Cocotrilito/watchywatch/bom.csv

Item | Qty | Purpose | Funding | UnitPriceUSD | TotalUSD | Supplier | Notes
HALO-0 RP2040 Board | 1 | Main controller | No | 0 | 0 | https://github.com/Cocotrilito/HALO-0 | Previously designed by me and reused as the main controller
4-Digit 7-Segment Display | 1 | Main time display | Yes | 1.39 | 1.39 | https://megatronica.cc/producto/display-multiplexado-4-digitos/ | 0.56 inch common-anode red display
74HC595 DIP-16 | 2 | Reduce GPIO usage and drive display segments/digit selection | Yes | 0.95 | 1.90 | https://www.electronicajnc.com/web/producto/shift-register-74hc595/ | DIP-16 shift register; card payment still needs confirmation with supplier
2N3906 PNP Transistor | 4 | High-side switching for the four common-anode digits | Yes | 0.25 | 1.00 | https://novatronicec.com/index.php/product/transistor-2n3906-pnp/ | TO-92 package
DS1302 RTC Module | 1 | Keep time while the main system is powered off | Yes | 3.60 | 3.60 | https://novatronicec.com/ | 3-wire RTC module
LiPo Battery 401030 | 1 | Main rechargeable power source | Yes | 2.50 | 2.50 | https://www.cineto.net/producto/bateria-lipo-90mah-3-7v-401030/ | 3.7V 90mAh, 30x10x4 mm; payment method should be confirmed
134N3P / TP5400 Power Module | 1 | Charge the LiPo and boost battery voltage to 5V | Yes | 2.55 | 2.55 | https://novatronicec.com/index.php/product-category/fuentes-y-adaptadores-de-voltaje/ | 20x18.2x10.5 mm
Push Button 6x6x5mm | 2 | MODE and SET user inputs | Yes | 0.25 | 0.50 | https://novatronicec.com/ | Momentary tactile switches
Mini Power Switch | 1 | Main ON/OFF control | Yes | 0.60 | 0.60 | https://megatronica.cc/ | Small manual power switch
Blue LED 5mm | 1 | Status indicator | Yes | 0.10 | 0.10 | https://megatronica.cc/ | Blue indicator LED
LDR 5528 | 1 | Ambient light sensing for automatic display brightness | Yes | 0.40 | 0.40 | https://novatronicec.com/ | 5mm photoresistor
330 Ohm Resistor | 9 | Limit current for display segments and blue LED | Yes | 0.05 | 0.45 | https://tecmikro.com/resistencias-electricas-potenciometros/184-resistencias-de-14w.html | 1/4W
2.2k Ohm Resistor | 4 | Limit PNP base current | Yes | 0.05 | 0.20 | https://tecmikro.com/resistencias-electricas-potenciometros/184-resistencias-de-14w.html | 1/4W
10k Ohm Resistor | 5 | PNP pull-ups and LDR voltage divider | Yes | 0.05 | 0.25 | https://tecmikro.com/resistencias-electricas-potenciometros/184-resistencias-de-14w.html | 1/4W
100k Ohm Resistor | 2 | Battery voltage sensing divider | Yes | 0.05 | 0.10 | https://tecmikro.com/resistencias-electricas-potenciometros/184-resistencias-de-14w.html | 1/4W
100nF Ceramic Capacitor | 2 | Decouple the two 74HC595 ICs | Yes | 0.25 | 0.50 | https://megatronica.cc/producto/capacitor-ceramico-01-uf-100nf-104-250v-2/ | 0.1uF ceramic through-hole capacitor
Perfboard 5x7cm | 1 | Hand-soldered point-to-point electronics assembly | Yes | 0.95 | 0.95 | https://megatronica.cc/store/page/32/ | Will be cut down to the size required by the enclosure
Hookup Wire | 1 | Internal point-to-point wiring | Yes | 3.99 | 3.99 | https://megatronica.cc/store/page/32/ | 1 meter 40-wire Dupont ribbon can be separated into individual wires
3D Printed Enclosure | 1 | Custom wearable enclosure | No | 0 | 0 | TBD | Designed in Fusion 360 and printed using my own 3D printer
Watch Strap | 1 | Attach the device to the wrist | Yes | TBD | TBD | TBD | Must fit the strap slots modeled into the enclosure
