Cocotrilito/watchywatch/ArtyomWatchv1.kicad_sch

## KiCad design ArtyomWatchv1.kicad_sch (2026-11-01)

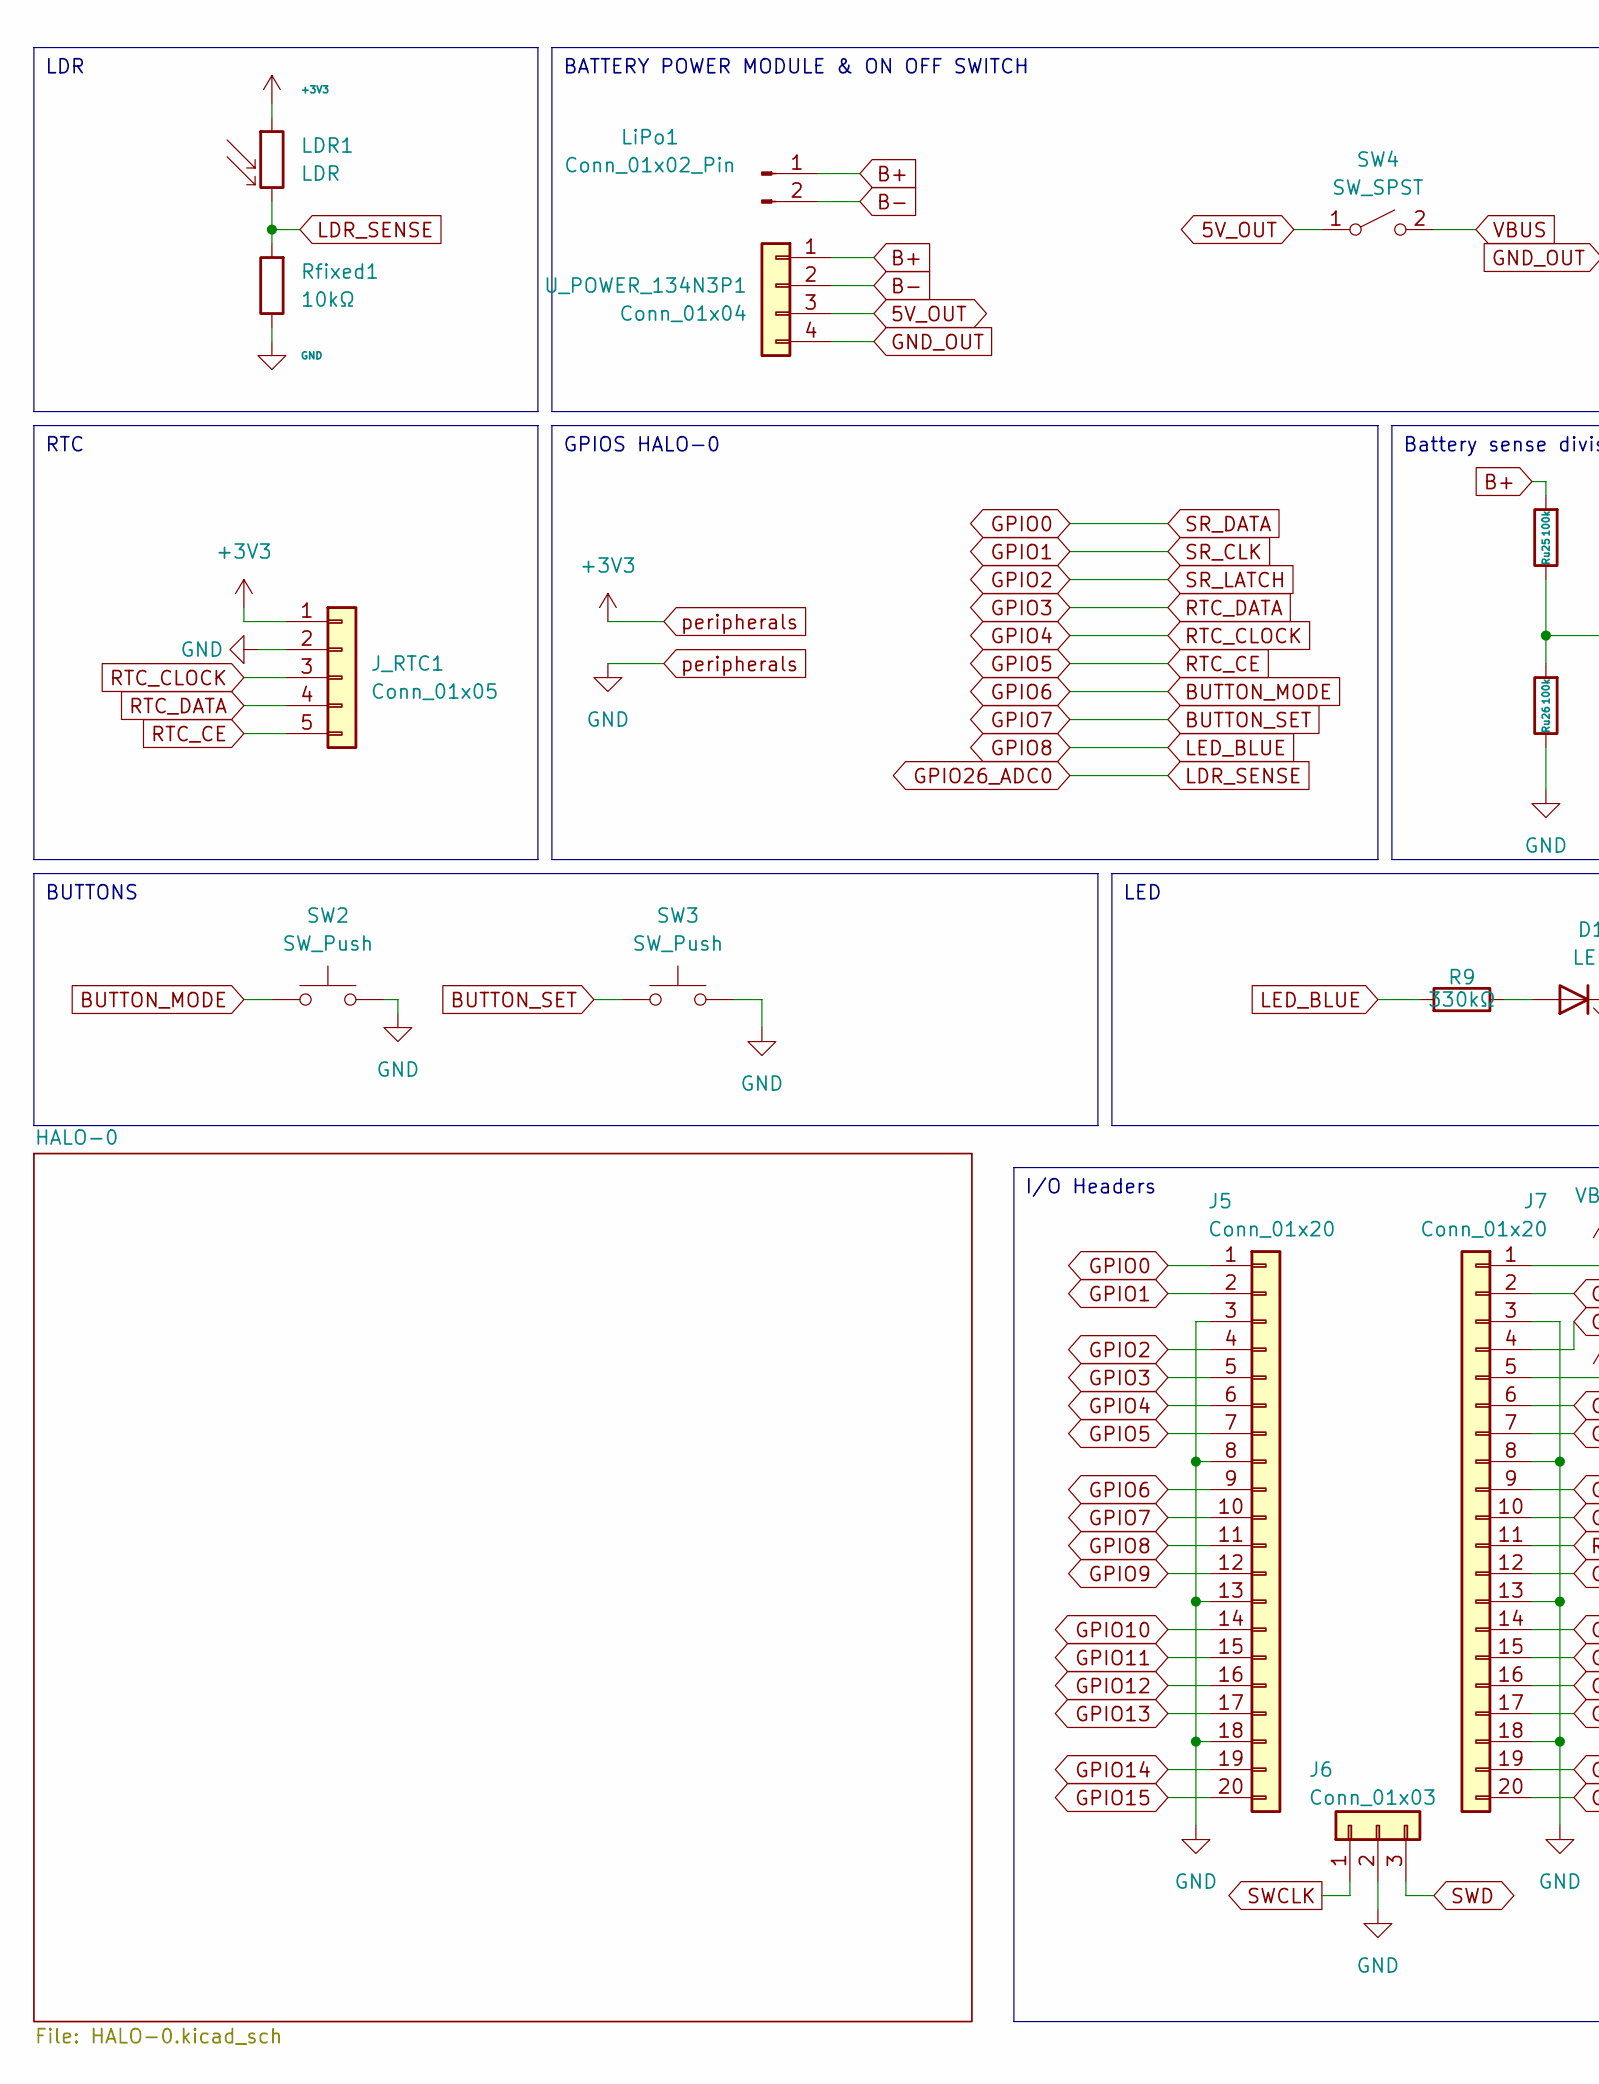
[picture p5: schematic ArtyomWatchv1.kicad_sch, part in row 1, column 1]

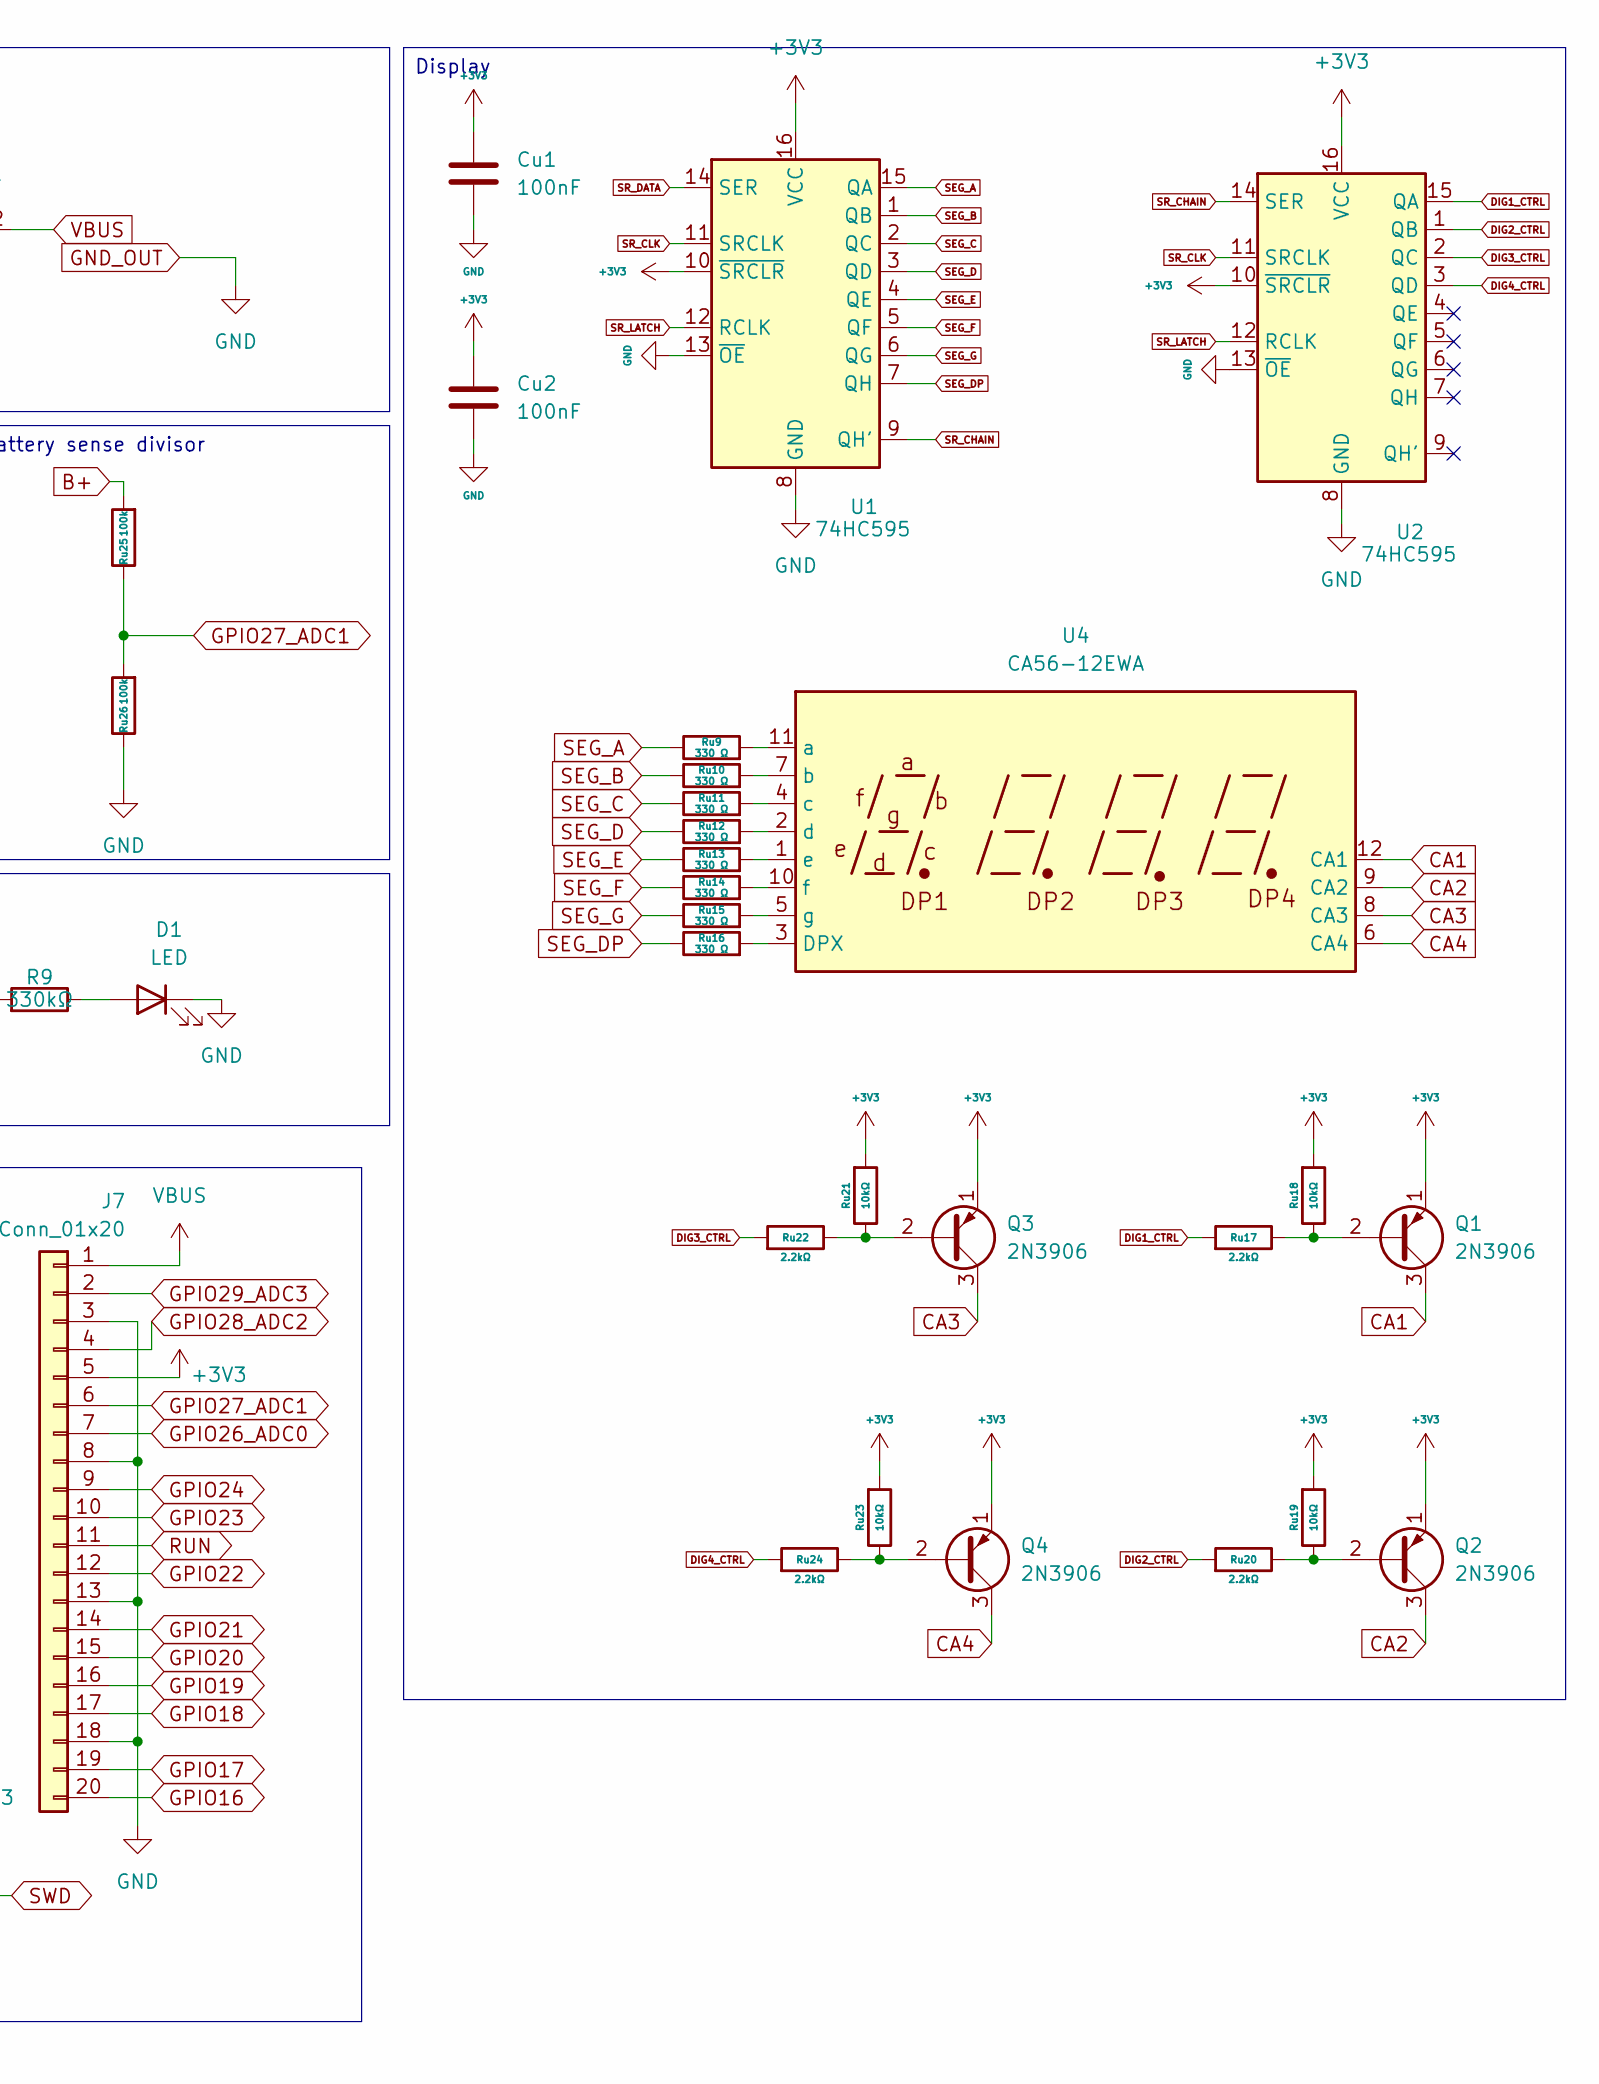
[picture p6: schematic ArtyomWatchv1.kicad_sch, part in row 1, column 2]

Parts:
Cu1, Cu2: 100nF
D1: LED
J5, J7: Conn_01x20; PinHeader_1x20_P2.54mm_Vertical
J6: Conn_01x03; PinHeader_1x03_P2.54mm_Vertical
J_RTC1: Conn_01x05
LDR1: LDR
LiPo1: Conn_01x02_Pin
Q1, Q2, Q3, Q4: 2N3906; TO-92_Inline
R9: 330kΩ
Rfixed1: 10kΩ
Ru9, Ru10, Ru11, Ru12, Ru13, Ru14, Ru15, Ru16: 330 Ω
Ru17, Ru20, Ru22, Ru24: 2.2kΩ
Ru18, Ru19, Ru21, Ru23: 10kΩ
Ru25, Ru26: 100k
SW2, SW3: SW_Push
SW4: SW_SPST
U1, U2: 74HC595
U4: CA56-12EWA
U_POWER_134N3P1: Conn_01x04

Connections:
5V_OUT: SW4.1 (A), U_POWER_134N3P1.3
+3V3: Cu1.1, Cu1.2, Cu2.1, Cu2.2, D1.1 (K), J5.3, J5.8, J5.13, J5.18, J6.2, J7.3, J7.5, J7.8, J7.13, J7.18, J_RTC1.1, J_RTC1.2, LDR1.1, Q1.1 (E), Q2.1 (E), Q3.1 (E), Q4.1 (E), Rfixed1.1, Ru18.2, Ru19.2, Ru21.2, Ru23.2, Ru26.1, SW2.2, SW3.2, U1.8 (GND), U1.10 (~SRCLR), U1.13 (~OE), U1.16 (VCC), U2.8 (GND), U2.10 (~SRCLR), U2.13 (~OE), U2.16 (VCC), U_POWER_134N3P1.4
B+: LiPo1.1, Ru25.2, U_POWER_134N3P1.1
B-: LiPo1.2, U_POWER_134N3P1.2
BUTTON_MODE: J5.9, SW2.1
BUTTON_SET: J5.10, SW3.1
CA1: Q1.3 (C), U4.12 (CA1)
CA2: Q2.3 (C), U4.9 (CA2)
CA3: Q3.3 (C), U4.8 (CA3)
CA4: Q4.3 (C), U4.6 (CA4)
DIG1_CTRL: Ru17.2, U2.15 (QA)
DIG2_CTRL: Ru20.2, U2.1 (QB)
DIG3_CTRL: Ru22.2, U2.2 (QC)
DIG4_CTRL: Ru24.2, U2.3 (QD)
GPIO0: J5.1, U1.14 (SER)
GPIO1: J5.2, U1.11 (SRCLK), U2.11 (SRCLK)
GPIO2: J5.4, U1.12 (RCLK), U2.12 (RCLK)
GPIO3: J5.5, J_RTC1.4
GPIO4: J5.6, J_RTC1.3
GPIO5: J5.7, J_RTC1.5
GPIO8: J5.11, R9.2
GPIO9: J5.12
GPIO10: J5.14
GPIO11: J5.15
GPIO12: J5.16
GPIO13: J5.17
GPIO14: J5.19
GPIO15: J5.20
GPIO16: J7.20
GPIO17: J7.19
GPIO18: J7.17
GPIO19: J7.16
GPIO20: J7.15
GPIO21: J7.14
GPIO22: J7.12
GPIO23: J7.10
GPIO24: J7.9
GPIO26_ADC0: J7.7, LDR1.2, Rfixed1.2
GPIO27_ADC1: J7.6, Ru25.1, Ru26.2
GPIO28_ADC2: J7.4
GPIO29_ADC3: J7.2
unnamed: D1.2 (A), R9.1
unnamed: Q1.2 (B), Ru17.1, Ru18.1
unnamed: Q2.2 (B), Ru19.1, Ru20.1
unnamed: Q3.2 (B), Ru21.1, Ru22.1
unnamed: Q4.2 (B), Ru23.1, Ru24.1
unnamed: Ru9.2, U4.11 (a)
unnamed: Ru10.2, U4.7 (b)
unnamed: Ru11.2, U4.4 (c)
unnamed: Ru12.2, U4.2 (d)
unnamed: Ru13.2, U4.1 (e)
unnamed: Ru14.2, U4.10 (f)
unnamed: Ru15.2, U4.5 (g)
unnamed: Ru16.2, U4.3 (DPX)
RUN: J7.11
SEG_A: Ru9.1, U1.15 (QA)
SEG_B: Ru10.1, U1.1 (QB)
SEG_C: Ru11.1, U1.2 (QC)
SEG_D: Ru12.1, U1.3 (QD)
SEG_DP: Ru16.1, U1.7 (QH)
SEG_E: Ru13.1, U1.4 (QE)
SEG_F: Ru14.1, U1.5 (QF)
SEG_G: Ru15.1, U1.6 (QG)
SR_CHAIN: U1.9 (QH'), U2.14 (SER)
SWCLK: J6.1
SWD: J6.3
VBUS: J7.1, SW4.2 (B)

Notes on the sheet:
BATTERY POWER MODULE & ON OFF SWITCH
Display
LDR
LED
BUTTONS
I/O Headers
Battery sense divisor
RTC
GPIOS HALO-0
