Cocotrilito/watchywatch/HALO-0.kicad_sch

## KiCad design HALO-0.kicad_sch (2026-11-01)

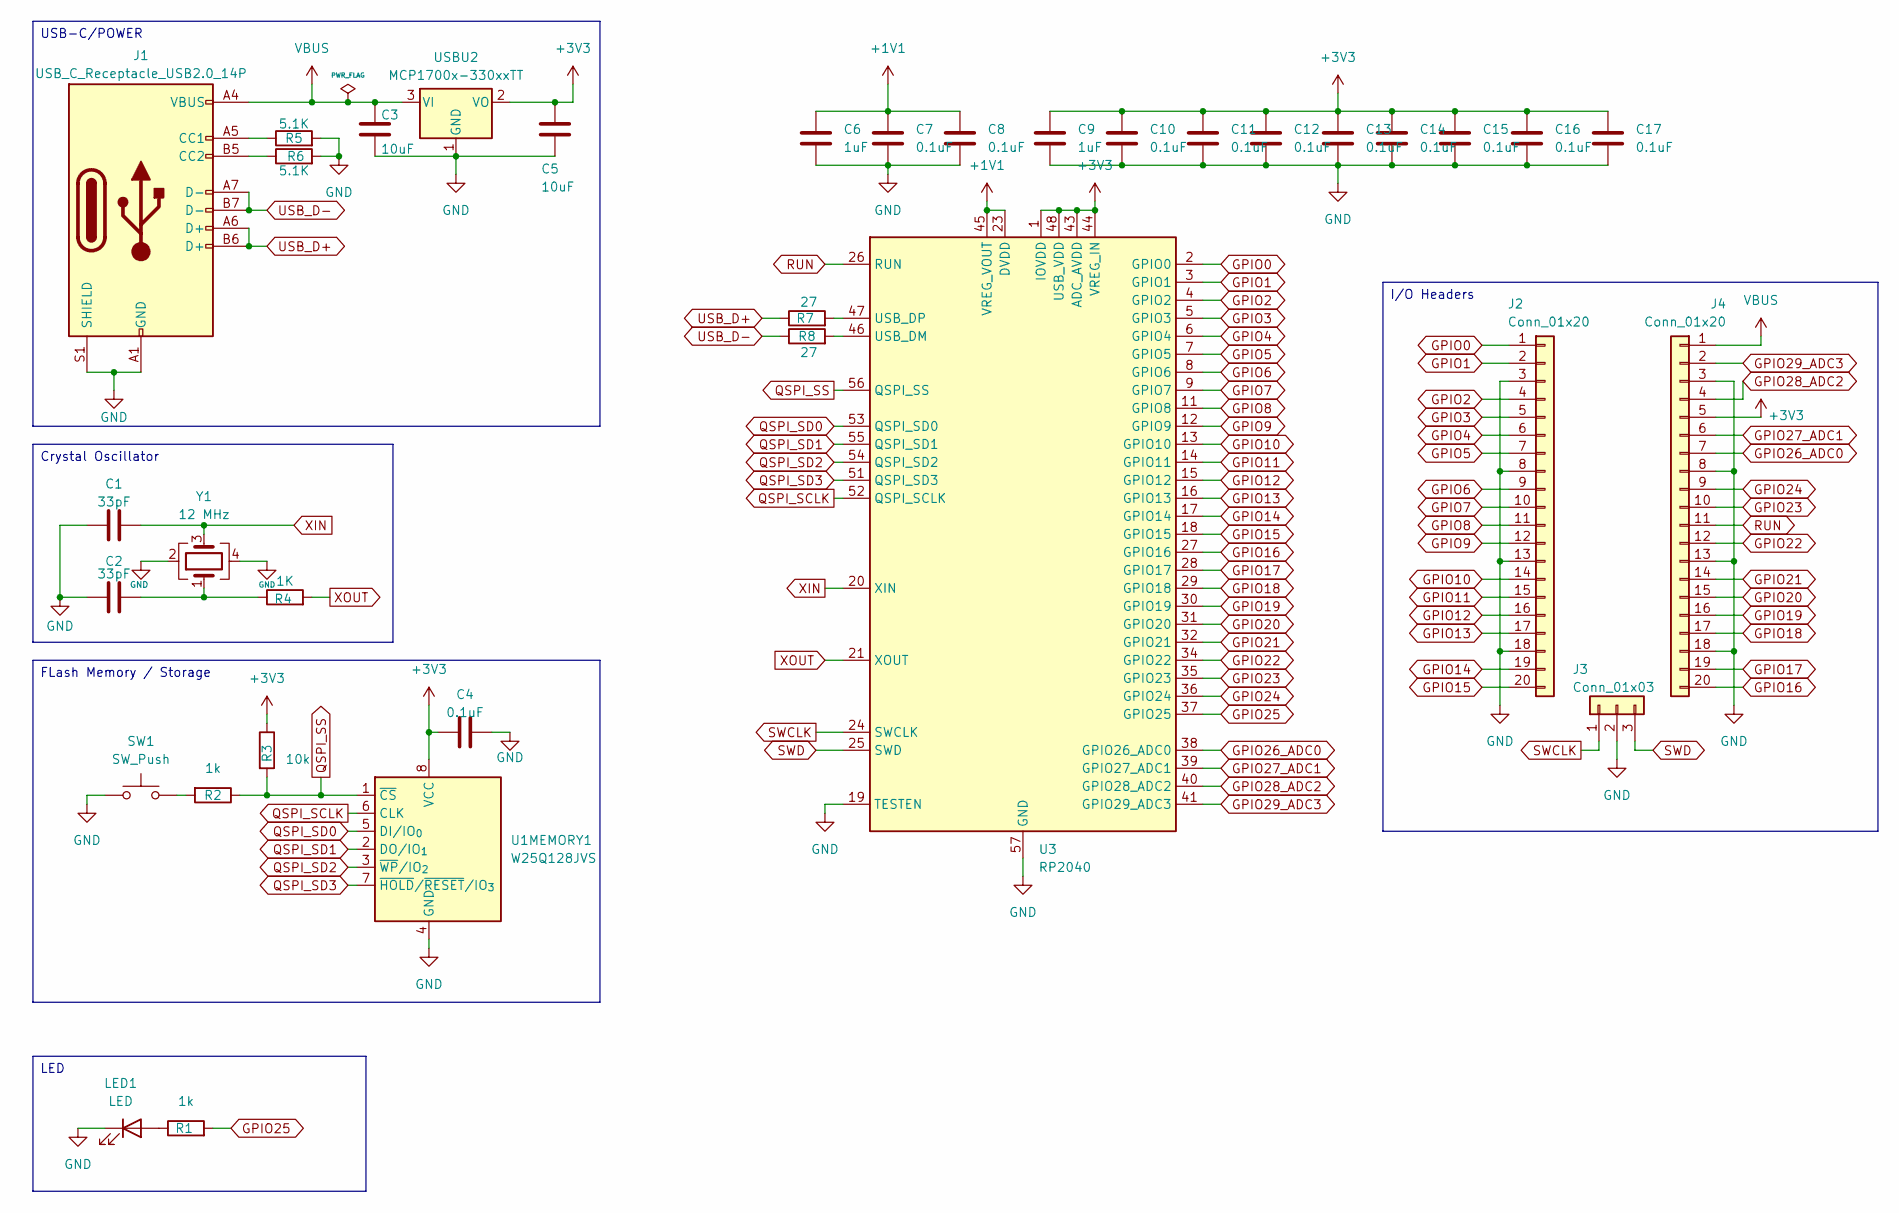
[picture p7: schematic HALO-0.kicad_sch]

Parts:
C1, C2: 33pF; C_0402_1005Metric
C3, C5: 10uF; C_0603_1608Metric
C4, C7, C8, C10, C11, C12, C13, C14, C15, C16, C17: 0.1uF; C_0402_1005Metric
C6, C9: 1uF; C_0402_1005Metric
J1: USB_C_Receptacle_USB2.0_14P; USB_C_Receptacle_HRO_TYPE-C-31-M-12
J2, J4: Conn_01x20; PinHeader_1x20_P2.54mm_Vertical
J3: Conn_01x03; PinHeader_1x03_P2.54mm_Vertical
LED1: LED; LED_0603_1608Metric
R1: 1k; R_0603_1608Metric
R2: 1k; R_0402_1005Metric
R3: 10k; R_0402_1005Metric
R4: 1K; R_0402_1005Metric
R5, R6: 5.1K; R_0402_1005Metric
R7, R8: 27; R_0402_1005Metric
SW1: SW_Push; SW_Push_SPST_NO_Alps_SKRK
U1MEMORY1: W25Q128JVS; Winbond_USON-8-1EP_3x2mm_P0.5mm_EP0.2x1.6mm
U3: RP2040; QFN-56-1EP_7x7mm_P0.4mm_EP3.2x3.2mm
USBU2: MCP1700x-330xxTT; SOT-23
Y1: 12 MHz; Crystal_SMD_3225-4Pin_3.2x2.5mm

Connections:
+1V1: C6.1, C7.1, C8.1, U3.23 (DVDD), U3.45 (VREG_VOUT), U3.50 (DVDD)
+3V3: C4.1, C5.1, C9.1, C10.1, C11.1, C12.1, C13.1, C14.1, C15.1, C16.1, C17.1, J4.5, R3.1, U1MEMORY1.8 (VCC), U3.1 (IOVDD), U3.10 (IOVDD), U3.22 (IOVDD), U3.33 (IOVDD), U3.42 (IOVDD), U3.43 (ADC_AVDD), U3.44 (VREG_IN), U3.48 (USB_VDD), U3.49 (IOVDD), USBU2.2 (VO)
GND: C1.1, C2.1, C3.2, C4.2, C5.2, C6.2, C7.2, C8.2, C9.2, C10.2, C11.2, C12.2, C13.2, C14.2, C15.2, C16.2, C17.2, J1.A1 (GND), J1.A12 (GND), J1.B1 (GND), J1.B12 (GND), J1.S1 (SHIELD), J2.3, J2.8, J2.13, J2.18, J3.2, J4.3, J4.8, J4.13, J4.18, LED1.1 (K), R5.2, R6.2, SW1.1, U1MEMORY1.4 (GND), U3.19 (TESTEN), U3.57 (GND), USBU2.1 (GND), Y1.2, Y1.4
GPIO0: J2.1, U3.2 (GPIO0)
GPIO1: J2.2, U3.3 (GPIO1)
GPIO2: J2.4, U3.4 (GPIO2)
GPIO3: J2.5, U3.5 (GPIO3)
GPIO4: J2.6, U3.6 (GPIO4)
GPIO5: J2.7, U3.7 (GPIO5)
GPIO6: J2.9, U3.8 (GPIO6)
GPIO7: J2.10, U3.9 (GPIO7)
GPIO8: J2.11, U3.11 (GPIO8)
GPIO9: J2.12, U3.12 (GPIO9)
GPIO10: J2.14, U3.13 (GPIO10)
GPIO11: J2.15, U3.14 (GPIO11)
GPIO12: J2.16, U3.15 (GPIO12)
GPIO13: J2.17, U3.16 (GPIO13)
GPIO14: J2.19, U3.17 (GPIO14)
GPIO15: J2.20, U3.18 (GPIO15)
GPIO16: J4.20, U3.27 (GPIO16)
GPIO17: J4.19, U3.28 (GPIO17)
GPIO18: J4.17, U3.29 (GPIO18)
GPIO19: J4.16, U3.30 (GPIO19)
GPIO20: J4.15, U3.31 (GPIO20)
GPIO21: J4.14, U3.32 (GPIO21)
GPIO22: J4.12, U3.34 (GPIO22)
GPIO23: J4.10, U3.35 (GPIO23)
GPIO24: J4.9, U3.36 (GPIO24)
GPIO25: R1.2, U3.37 (GPIO25)
GPIO26_ADC0: J4.7, U3.38 (GPIO26_ADC0)
GPIO27_ADC1: J4.6, U3.39 (GPIO27_ADC1)
GPIO28_ADC2: J4.4, U3.40 (GPIO28_ADC2)
GPIO29_ADC3: J4.2, U3.41 (GPIO29_ADC3)
unnamed: C2.2, R4.1, Y1.1
unnamed: J1.A5 (CC1), R5.1
unnamed: J1.B5 (CC2), R6.1
unnamed: LED1.2 (A), R1.1
unnamed: R2.2, SW1.2
unnamed: R7.2, U3.47 (USB_DP)
unnamed: R8.2, U3.46 (USB_DM)
QSPI_SCLK: U1MEMORY1.6 (CLK), U3.52 (QSPI_SCLK)
QSPI_SD0: U1MEMORY1.5 (DI/IO_{0}), U3.53 (QSPI_SD0)
QSPI_SD1: U1MEMORY1.2 (DO/IO_{1}), U3.55 (QSPI_SD1)
QSPI_SD2: U1MEMORY1.3 (~WP/IO_{2}), U3.54 (QSPI_SD2)
QSPI_SD3: U1MEMORY1.7 (~HOLD/~RESET/IO_{3}), U3.51 (QSPI_SD3)
QSPI_SS: R2.1, R3.2, U1MEMORY1.1 (~CS), U3.56 (QSPI_SS)
RUN: J4.11, U3.26 (RUN)
SWCLK: J3.1, U3.24 (SWCLK)
SWD: J3.3, U3.25 (SWD)
USB_D+: J1.A6 (D+), J1.B6 (D+), R7.1
USB_D-: J1.A7 (D-), J1.B7 (D-), R8.1
VBUS: C3.1, J1.A4 (VBUS), J1.A9 (VBUS), J1.B4 (VBUS), J1.B9 (VBUS), J4.1, USBU2.3 (VI)
XIN: C1.2, U3.20 (XIN), Y1.3
XOUT: R4.2, U3.21 (XOUT)

Notes on the sheet:
I/O Headers
USB-C/POWER
Crystal Oscillator
LED
FLash Memory / Storage
