Cocotrilito/watchywatch/(commit log)

2026-11-01 Schematic and project files
    [ArtyomWatchv1.kicad_sch, HALO-0.kicad_sch]
2026-11-01 bom sample with straps tbd
    [bom.csv]
2026-11-01 Schematic img
